jaisor/SNAP_Power_Controller/SNAP_Power_Controller.kicad_pcb

## KiCad design SNAP_Power_Controller.kicad_pcb (2026-11-12)

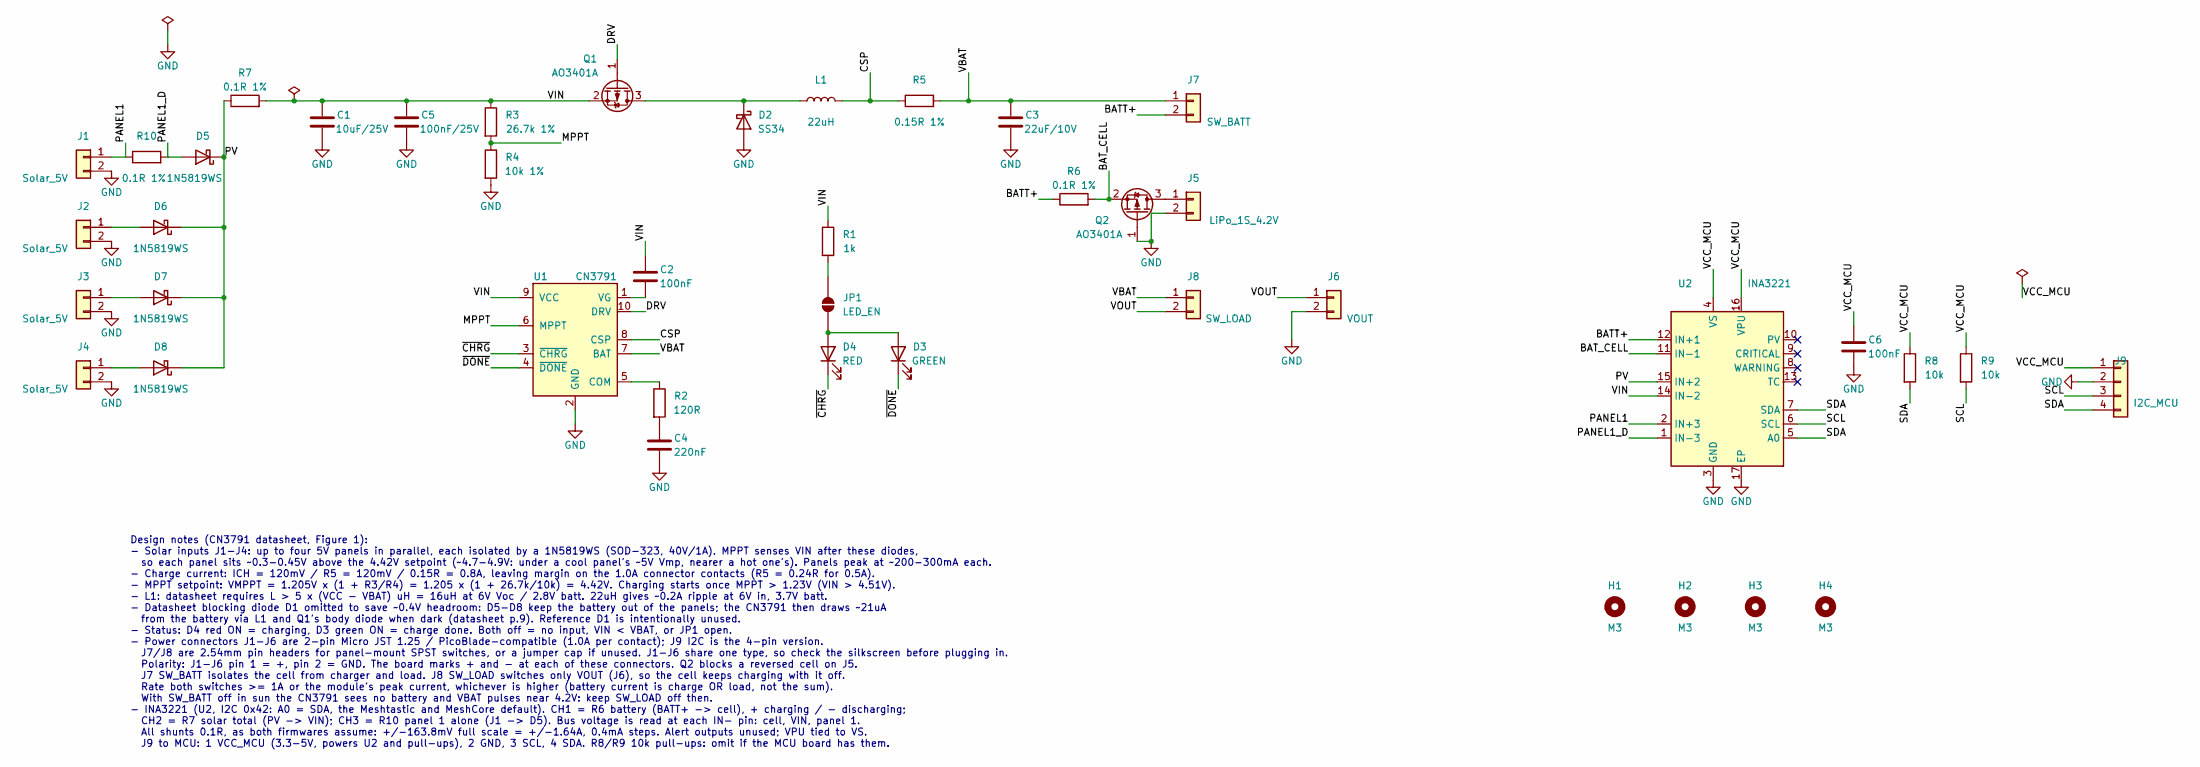
[picture p7: schematic SNAP_Power_Controller.kicad_sch, SNAP Power Controller]

Parts:
C1: 10uF/25V; C_1206_3216Metric
C2, C6: 100nF; C_0603_1608Metric
C3: 22uF/10V; C_1206_3216Metric
C4: 220nF; C_0603_1608Metric
C5: 100nF/25V; C_0603_1608Metric
D2: SS34; D_SMA
D3: GREEN; LED_0603_1608Metric
D4: RED; LED_0603_1608Metric
D5, D6, D7, D8: 1N5819WS; D_SOD-323
H1, H2, H3, H4: M3; MountingHole_3.2mm_M3
J1, J2, J3, J4: Solar_5V; Molex_PicoBlade_53047-0210_1x02_P1.25mm_Vertical
J5: LiPo_1S_4.2V; Molex_PicoBlade_53047-0210_1x02_P1.25mm_Vertical
J6: VOUT; Molex_PicoBlade_53047-0210_1x02_P1.25mm_Vertical
J7: SW_BATT; PinHeader_1x02_P2.54mm_Vertical
J8: SW_LOAD; PinHeader_1x02_P2.54mm_Vertical
J9: I2C_MCU; Molex_PicoBlade_53047-0410_1x04_P1.25mm_Vertical
JP1: LED_EN; SolderJumper-2_P1.3mm_Open_RoundedPad1.0x1.5mm
L1: 22uH; L_Bourns_SRN6045TA
Q1, Q2: AO3401A; SOT-23
R1: 1k; R_0603_1608Metric
R2: 120R; R_0603_1608Metric
R3: 26.7k 1%; R_0603_1608Metric
R4: 10k 1%; R_0603_1608Metric
R5: 0.15R 1%; R_1206_3216Metric
R6, R7: 0.1R 1%; R_1206_3216Metric
R8, R9: 10k; R_0603_1608Metric
R10: 0.1R 1%; R_0603_1608Metric
U1: CN3791; SSOP-10_3.9x4.9mm_P1.00mm
U2: INA3221; Texas_RGV0016A_VQFN-16-1EP_4x4mm_P0.65mm_EP2.1x2.1mm

Connections:
/BATT+: J7.2, R6.1, U2.12 (IN+1)
/BAT_CELL: Q2.2 (S), R6.2, U2.11 (IN-1)
/CSP: L1.2, R5.1, U1.8 (CSP)
/DRV: Q1.1 (G), U1.10 (DRV)
/MPPT: R3.2, R4.1, U1.6 (MPPT)
/PANEL1: J1.1, R10.1, U2.2 (IN+3)
/PANEL1_D: D5.2 (A), R10.2, U2.1 (IN-3)
/PV: D5.1 (K), D6.1 (K), D7.1 (K), D8.1 (K), R7.1, U2.15 (IN+2)
/SCL: J9.3, R9.2, U2.6 (SCL)
/SDA: J9.4, R8.2, U2.5 (A0), U2.7 (SDA)
/VBAT: C3.1, J7.1, J8.1, R5.2, U1.7 (BAT)
/VCC_MCU: C6.1, J9.1, R8.1, R9.1, U2.4 (VS), U2.16 (VPU)
/VIN: C1.1, C2.1, C5.1, Q1.2 (S), R1.1, R3.1, R7.2, U1.9 (VCC), U2.14 (IN-2)
/VOUT: J6.1, J8.2
/~CHRG: D4.1 (K), U1.3 (~CHRG)
/~DONE: D3.1 (K), U1.4 (~DONE)
GND: C1.2, C3.2, C4.2, C5.2, C6.2, D2.2 (A), J1.2, J2.2, J3.2, J4.2, J5.2, J6.2, J9.2, Q2.1 (G), R4.2, U1.2 (GND), U2.3 (GND), U2.17 (EP)
unnamed: C4.1, R2.2
unnamed: D2.1 (K), L1.1, Q1.3 (D)
unnamed: D3.2 (A), D4.2 (A), JP1.1 (A)
unnamed: D6.2 (A), J2.1
unnamed: D7.2 (A), J3.1
unnamed: D8.2 (A), J4.1
unnamed: J5.1, Q2.3 (D)
unnamed: JP1.2 (B), R1.2
unnamed: R2.1, U1.5 (COM)
unnamed: C2.2, U1.1 (VG)

Notes on the sheet:
Design notes (CN3791 datasheet, Figure 1): - Solar inputs J1-J4: up to four 5V panels in parallel, each isolated by a 1N5819WS (SOD-323, 40V/1A). MPPT senses VIN after these diodes, so each panel sits ~0.3-0.45V above the 4.42V setpoint (~4.7-4.9V: under a cool panel's ~5V Vmp, nearer a hot one's).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

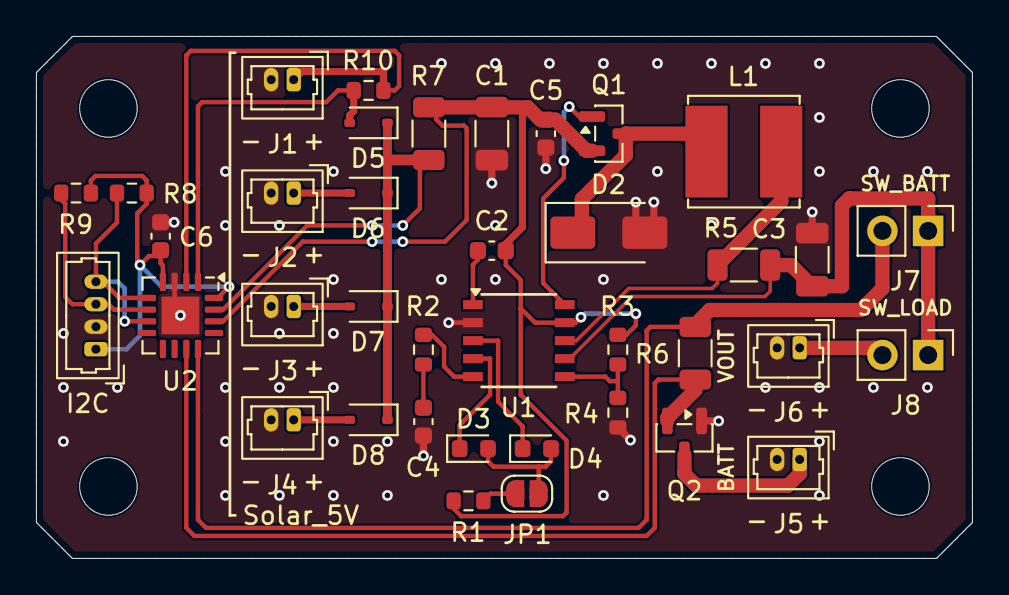
[picture p8: board SNAP_Power_Controller.kicad_pcb from above]

Board: 2 copper layers, 52.0 x 29.0 mm, 42 parts (0 on the bottom side), 27 nets.
