jaisor/SNAP_Power_Controller/(commit log)

2026-11-06 fix: correct battery and VOUT connector polarity for v1.1
    J5 and J6 now have pin 1 = GND and pin 2 = +. Add + and - silkscreen
    marks at the solar, battery and VOUT connectors, and set the back label
    to v1.1, Nov. 5, 2026. Re-routed; ERC and DRC are clean.
    [SolarNodeChargeController.kicad_pcb, SolarNodeChargeController.kicad_sch]
2026-11-06 fix: restore J5 and J6 pinout, keep the polarity marks
    The v1.0 pinout was correct, so J5 and J6 go back to pin 1 = +, pin 2 =
    GND. The + and - marks stay and now read "+ Jn -" on those connectors.
    Re-routed; ERC and DRC are clean.
    Carry the design notes position saved in KiCad into the generator, and
    ignore KiCad's local history folder.
    [SolarNodeChargeController.kicad_pcb, SolarNodeChargeController.kicad_sch]
2026-11-06 fix(pcb): restore v1.0 copper in v1.1, change silkscreen only
    The board was re-routed when J5 and J6 were swapped back, although the nets
    had returned to v1.0's. The re-route changed the copper for no design reason.
    Take the board from fb5b665 and apply only the polarity marks, back label and
    revision. Copper, mask, paste, outline and drill output match v1.0, with
    206 track segments and 45 vias.
    [SolarNodeChargeController.kicad_pcb]
2026-11-06 docs: record the first board test and correct the XIAO I2C pins
    A first board now works with a XIAO + Wio-SX1262 on a custom Meshtastic
    build, including the INA219. Add a Testing section with that result and the
    4-panel sunlight test that comes next. No measured figures yet.
    The wiring table said D4 and D5 for I2C, but the Wio-SX1262 uses those pins
    for the radio. Use D6 and D7, as tested, and list the pins for the other
    builds. Those rows come from the firmware source and are marked untested.
2026-11-06 docs: record the INA219 battery current readings
    Add the first current readings with the battery at about 4V: about -12 to
    -15mA discharging and +100mA charging from the XIAO's USB. The signs match
    the documented convention. USB charging goes through the XIAO's own charger,
    so solar charging through the CN3791 is still unmeasured.
2026-11-06 feat(pcb): use 2.54mm pin headers for the J7 and J8 switch connectors
    Replace the Micro JST 1.25 connectors on SW_BATT and SW_LOAD with standard
    2.54mm vertical pin headers. An unused one can now take a jumper cap, and a
    switch plug can no longer be confused with the J1-J6 power connectors.
    The board was patched rather than re-routed. The wider pin spacing moved
    both headers about 1.2mm left, so only the VBAT, BATT+ and VOUT copper around
    them changed: 242 of 251 tracks and vias are untouched. ERC and DRC are clean,
    and place-pcb.py gives the same placement and labels. This version hasn't
    been built, and the board silkscreen stays at v1.1.
    Also record the first sunlight test: a JST board i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
    [SolarNodeChargeController.kicad_pcb, SolarNodeChargeController.kicad_sch]
2026-11-08 docs: show the J7/J8 pin headers in the wiring diagram
    The board render already showed the 2.54mm headers, but the callouts and
    subtitle still described the switch connectors as JST. Label J7 and J8 as
    2.54mm headers, note that a jumper cap can replace an unused switch, and
    move the switches right so the wider callouts fit.
2026-11-09 docs: license the design under CERN-OHL-P-2.0 and the scripts under MIT
    Add the CERN Open Hardware Licence v2 Permissive for the hardware design
    and documentation. Its disclaimer and liability exclusion (section 5)
    covers products made from the design, including product liability,
    which MIT and Apache don't, since they're written for software. The
    scripts in tools/ are MIT, with an SPDX line at the top of each.
    The README gets the licence notice and a Safety section setting out what
    a builder is responsible for: assembly and polarity, a protected cell,
    fusing and the enclosure.
2026-11-09 feat: add reverse-battery P-FET and LED jumper, lower MPPT to 4.42V
    Q2 (AO3401A, the same part as Q1) sits between J5 pin 1 and BAT_CELL,
    with its gate on GND. A reversed cell used to short through the
    CN3791's BAT-pin diode and D2/L1/R5 once SW_BATT was closed, and drove
    the INA219 inputs below their -0.3V limit with SW3 on BATT. Now Vgs is
    about 0 and the body diode blocks. With the cell the right way round,
    Vgs = -Vcell turns Q2 fully on in both directions, costing about 60mV
    at 0.8A. To make room, the J5 track runs down to Q2 and a 4mm piece of
    SCL moves to B.Cu.
    JP1, an open solder jumper on the back, sits between VIN and R1, so
    the status LEDs stay off and draw nothing until it is bri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
    [SolarNodeChargeController.kicad_pcb, SolarNodeChargeController.kicad_sch]
2026-11-09 feat(pcb): move JP1 to the top and reorder J9 to VCC, GND, SCL, SDA
    JP1 was on the back, where it can't be reached once the board is
    mounted. It now sits right of R1 on the top. To fit there it moves to
    the other side of R1 (VIN -> R1 -> JP1 -> LED anodes), which works the
    same and lets VIN keep its original top-side route. JP1's two vias and
    the back "LED" label are gone.
    J9 follows the common red/black/yellow/white 4-wire cable: 1 VCC,
    2 GND, 3 SCL, 4 SDA. Only SDA and GND swap. SDA now reaches pin 4 on
    B.Cu, clear of the SCL pad, and pin 2 gets a solid zone connection,
    because a thermal relief starved there. route-pcb.py now applies that
    to J9 as well. v1.0 boards keep the old order (SDA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
    [SolarNodeChargeController.kicad_pcb, SolarNodeChargeController.kicad_sch]
2026-11-09 docs: record why R3 stays at 26.7k below the CN3791's 4.5V minimum
    The CN3791 datasheet specifies VCC 4.5-28V, with UVLO at 3.1/3.8/4.4V
    and an MPPT reference of 1.18/1.205/1.23V. That puts the 4.42V set
    point at 4.33-4.51V across parts, below the guaranteed minimum. It is
    kept anyway because the panels in use measure about 5.5V open-circuit.
    With those panels, in-spec values of 28k and up lose most of their
    output in heat and fail to start charging near 65C.
    The README notes the caveat and the in-spec alternative for 6V panels
    (R3 = 30.1k, 4.83V). CLAUDE.md records the modeled figures and the
    longer-term fixes.
2026-11-09 feat: replace the INA219 and SW3 with a three-channel INA3221
    The INA219 could only measure one shunt at a time, chosen with the
    SOLAR/BATT slide switch SW3, and firmware had no way to tell which. The
    INA3221 (VQFN-16) reads all three at once:
    - CH1: R6, battery current (+ charging / - discharging), cell voltage
    - CH2: R7, total solar current, VIN
    - CH3: new R10 (0.1R 0603) between J1 and D5, panel 1 alone, with the
    panel's own voltage before its diode
    A0 is tied to SDA for address 0x42, the INA3221 default in Meshtastic and
    MeshCore (both checked in source, and both assume 0.1R shunts). VPU is on
    VS and the alert outputs are unused.
    The PCB is a pcbnew patch on the routed board, so the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
    [SolarNodeChargeController.kicad_pcb, SolarNodeChargeController.kicad_sch]
2026-11-10 feat(pcb): re-route the board by hand and enlarge the ground pours
    The auto-routed copper was untidy: long diagonals, several B.Cu hops
    around the CN3791, and a top pour broken into pieces. The whole board is
    now drawn from fixed coordinates by tools/draw-routes.py, so
    place-pcb.py + draw-routes.py reproduces it exactly. route-pcb.py, the
    A* auto-router, stays for reference only.
    Seven passives are turned 180 degrees in place (C1, C2, C5, R2, R3, R4,
    C4) and D3/D4 swap positions, so nets stop crossing: VIN runs straight
    from R7 through C1 and C5 to Q1, VG and the COM and MPPT nodes become
    adjacent pads, and CHRG/DONE leave under the IC without a hop. The
    charger's CSP/VBAT sense pair goes s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
    [SolarNodeChargeController.kicad_pcb]
2026-11-10 feat(pcb): shrink the board to 52 x 29 mm
    Removing SW3 left the left end of the board mostly empty, and the parts
    were spaced more widely than the design rules need.
    Move J9 and the INA3221 to the left edge between the two mounting holes,
    put the battery shunt R6 and the reverse-battery FET Q2 under L1, and
    place the switch headers J7 and J8 between the right-hand holes. The
    solar inputs, charger and power stage keep their layout and shift 3 mm
    right. The board is 4.5 mm narrower; the height stays at 29 mm because
    the four stacked solar connectors set it. The 2 mm corner chamfers and
    the four M3 holes 4 mm from each edge are kept.
    With the INA3221 beside the solar inputs, both long B.Cu se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
    [SolarNodeChargeController.kicad_pcb]
2026-11-10 docs: add a change log and describe v1.1 as the released design
    The README still called the INA3221 board a branch and v1.1 a work in
    progress, which stopped being true when multi_channel_sensor merged
    into main. CHANGELOG.md lists what changed since v1.0 for someone
    building or using the board, with the points that break v1.0 setups
    (outline and hole pattern, J9 pinout, INA3221 at 0x42, pin headers)
    collected under "Upgrading from v1.0", and a note that the v1.1 files
    published on Nov. 5 were withdrawn.
    The README's fab-notes row said 0.25 mm minimum track; the board and
    FAB_NOTES.txt use 0.2 mm.
2026-11-10 fix(pcb): date the back label Nov. 9, 2026
    The back of the board still read Nov. 5, the date of the withdrawn
    silkscreen-only v1.1. The board being released as v1.1 was finished on
    Nov. 9, and a v1.1 board carrying the earlier date could be taken for
    the withdrawn one.
    Only the text changes, patched in the board file with place-pcb.py and
    the fab notes updated to match. Gerber and drill output compared with
    the previous export: B.Silkscreen is the only layer that differs. DRC
    with schematic parity: 0 violations, 0 unconnected, 0 parity issues.
    [SolarNodeChargeController.kicad_pcb]
2026-11-11 build(bom): name metal-element current-sense resistors for the shunts
    R5, R6, R7 and R10 were listed only as generic 0.1R / 0.15R 1% parts,
    so an assembler would fit ordinary thick-film resistors. At these
    values those drift a few hundred ppm/C. The drift in R5 moves the
    CN3791's charge current, and the drift in R6, R7 and R10 goes straight
    into the INA3221 readings.
    The BOM's Manufacturer Part column now gives Vishay WSL parts
    (WSL1206R1500FEA, WSL1206R1000FEA, WSL0603R1000FEA), about 75 ppm/C,
    "or equivalent, 100 ppm/C or better". Values and footprints are
    unchanged, so the schematic and board are not touched. Four-terminal
    shunts were not used: they need new footprints and re-routing, an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
2026-11-11 revert: go back to generic resistors for the shunts
    This reverts commit cc3e9e6, which named Vishay WSL metal-element
    current-sense resistors for R5, R6, R7 and R10 in the BOM.
    Those parts cost several times more than ordinary 1% thick-film
    resistors, and WSL1206R1500FEA was in short supply. The accuracy they
    buy is small for node telemetry: thick film drifts 1-3% over a 60 C
    swing, while the INA3221's own offset is already about 1.3% of a 60 mA
    panel reading, and the 0.8 A limit R5 sets is never reached with a few
    60 mA panels.
    CLAUDE.md keeps a note of the decision, so the same change is not
    proposed again. Apart from that note the tree matches ffb7b1d, the
    commit v1.1 was released from.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
2026-11-12 docs: point repo links at SNAP_Power_Controller
    The GitHub repository was renamed from SolarNodeChargeController to
    SNAP_Power_Controller. GitHub redirects the old address, but only until
    another repository takes the old name, so the README's release and
    source links and the remote recorded in CLAUDE.md use the new one.
    The local folder and the KiCad project files keep the old name.
2026-11-12 refactor: rename the KiCad project to SNAP_Power_Controller
    The GitHub repository is now SNAP_Power_Controller, so the project
    files, the title blocks and the README heading follow it:
    SNAP_Power_Controller.kicad_pro/.kicad_sch/.kicad_pcb, titled
    "SNAP Power Controller". The four tools and the README commands use
    the new file name, and the schematic image is re-exported.
    No design change. ERC 0; DRC 0 violations, 0 unconnected, 0 parity
    issues. Gerber and drill output matches the v1.1 release apart from
    file names and header lines.
    The back label and the fab file names still say "Solar Charge Module",
    because changing the label would make the board differ from the
    released v1.1. The wiring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
    [SNAP_Power_Controller.kicad_pcb, SNAP_Power_Controller.kicad_sch]
2026-11-12 docs: add board dimensions to the README and wiring diagram
    Anyone designing an enclosure or mounting plate needs the outline and
    hole positions, and until now they had to be read out of the board file
    or tools/place-pcb.py.
    The wiring diagram gains a to-scale outline drawing under the wiring:
    52 x 29 mm, 2 mm chamfers, four 3.2 mm non-plated M3 holes with centres
    4 mm from each edge (44 x 21 mm apart). The README's PCB section lists
    the same figures in a Dimensions table. make-diagram.py draws the strip
    from constants that mirror place-pcb.py, so the image is 400 px taller.
    Also correct the CLAUDE.md note about the v1.1 release: its Gerber zip
    was re-issued with SNAP_Power_Controller file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
